al177/tranz330_re/tranz330_re.pdf

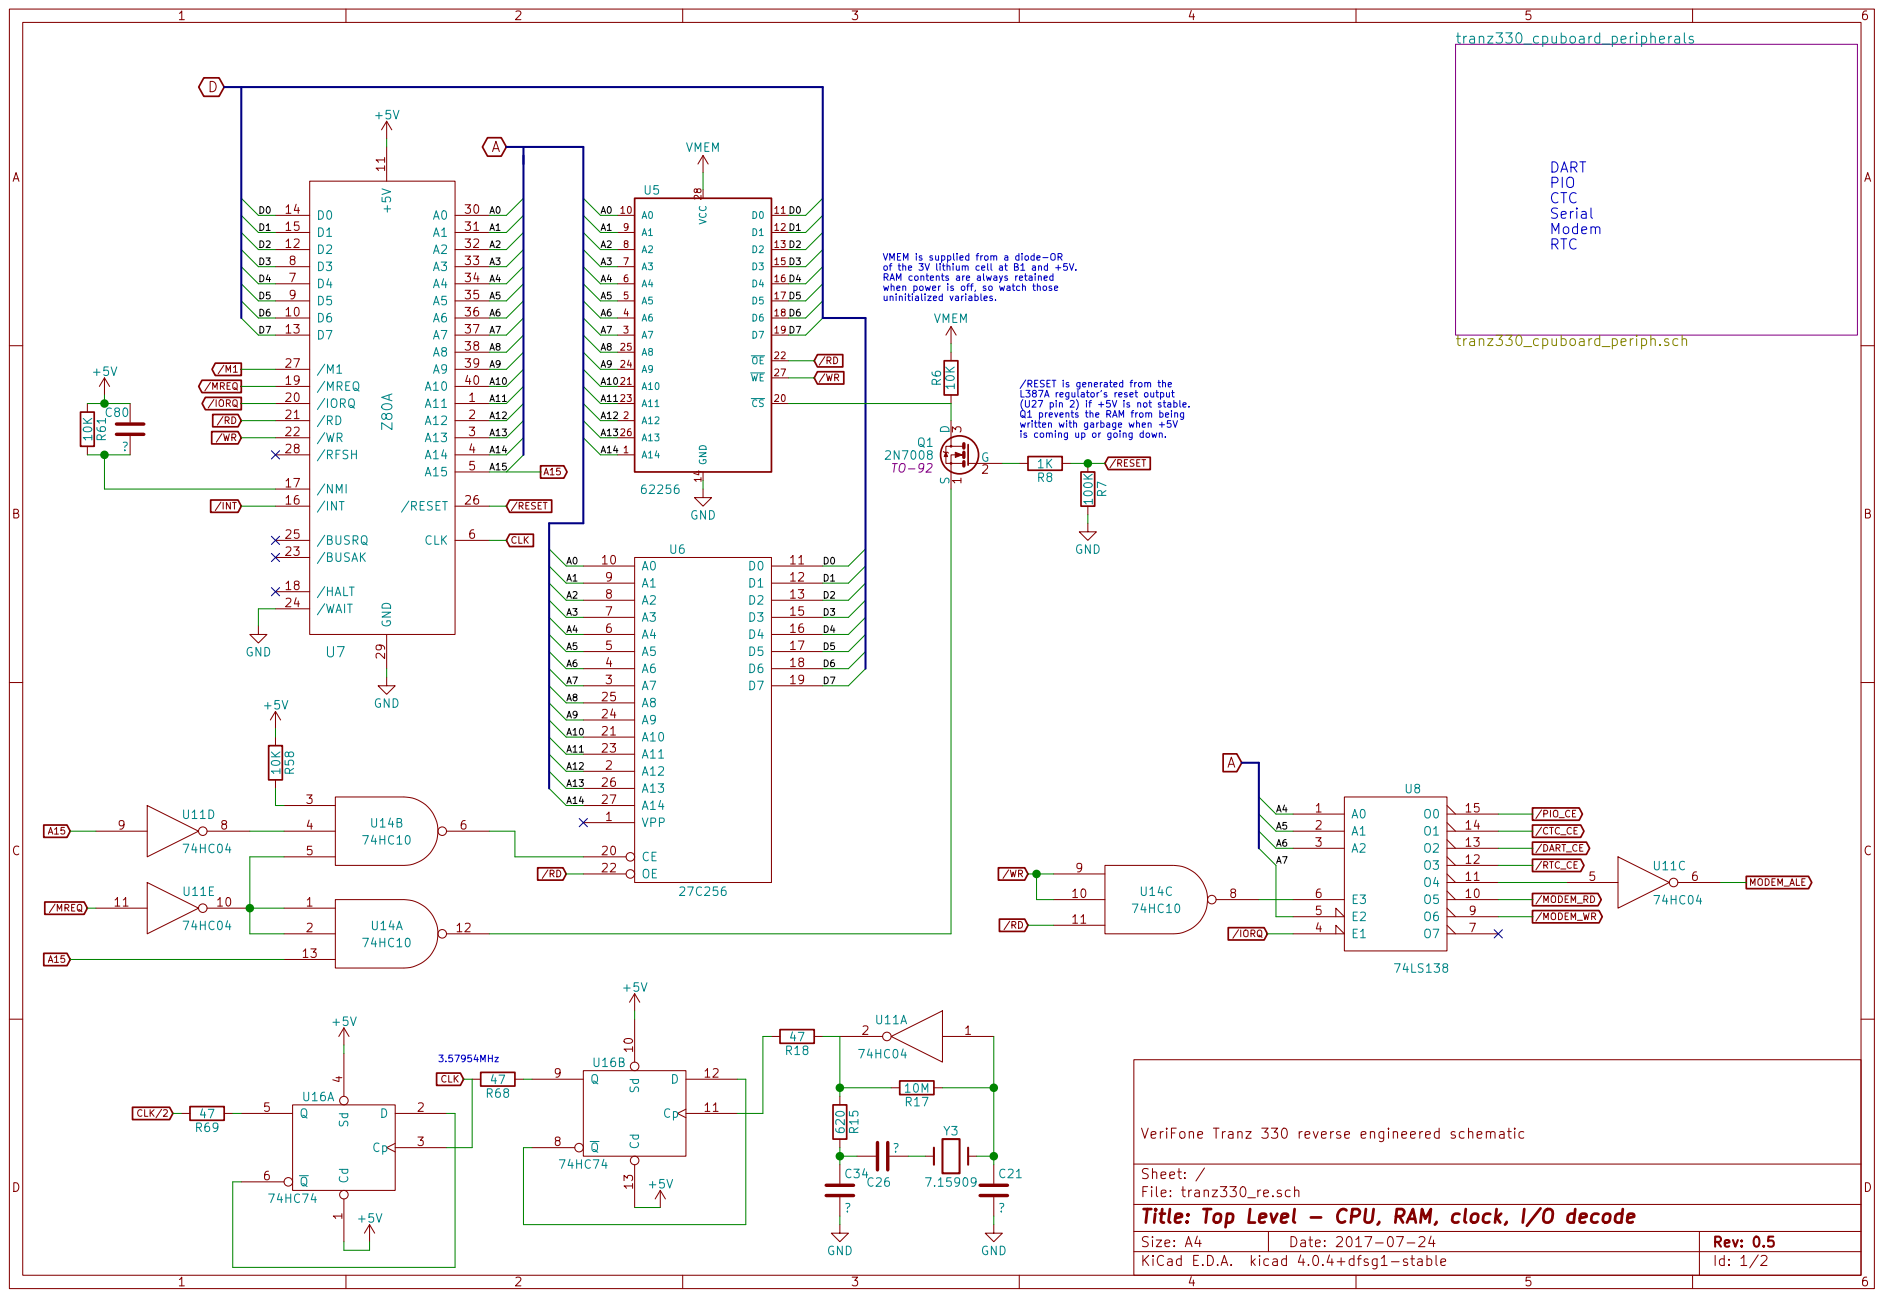
[picture p1: page 1]

is coming up or going down. VMEM is supplied from a diode-OR
of the 3V lithium cell at B1 and +5V. RAM contents are always retained when power is off, so watch those

/RESET is generated from the
L387A regulator's reset output (U27 pin 2) if +5V is not stable. Q1 prevents the RAM from being written with garbage when +5V

File: tranz330_re.sch Sheet: / VeriFone Tranz 330 reverse engineered schematic

Id: 1/2 Title: Top Level - CPU, RAM, clock, I/O decode

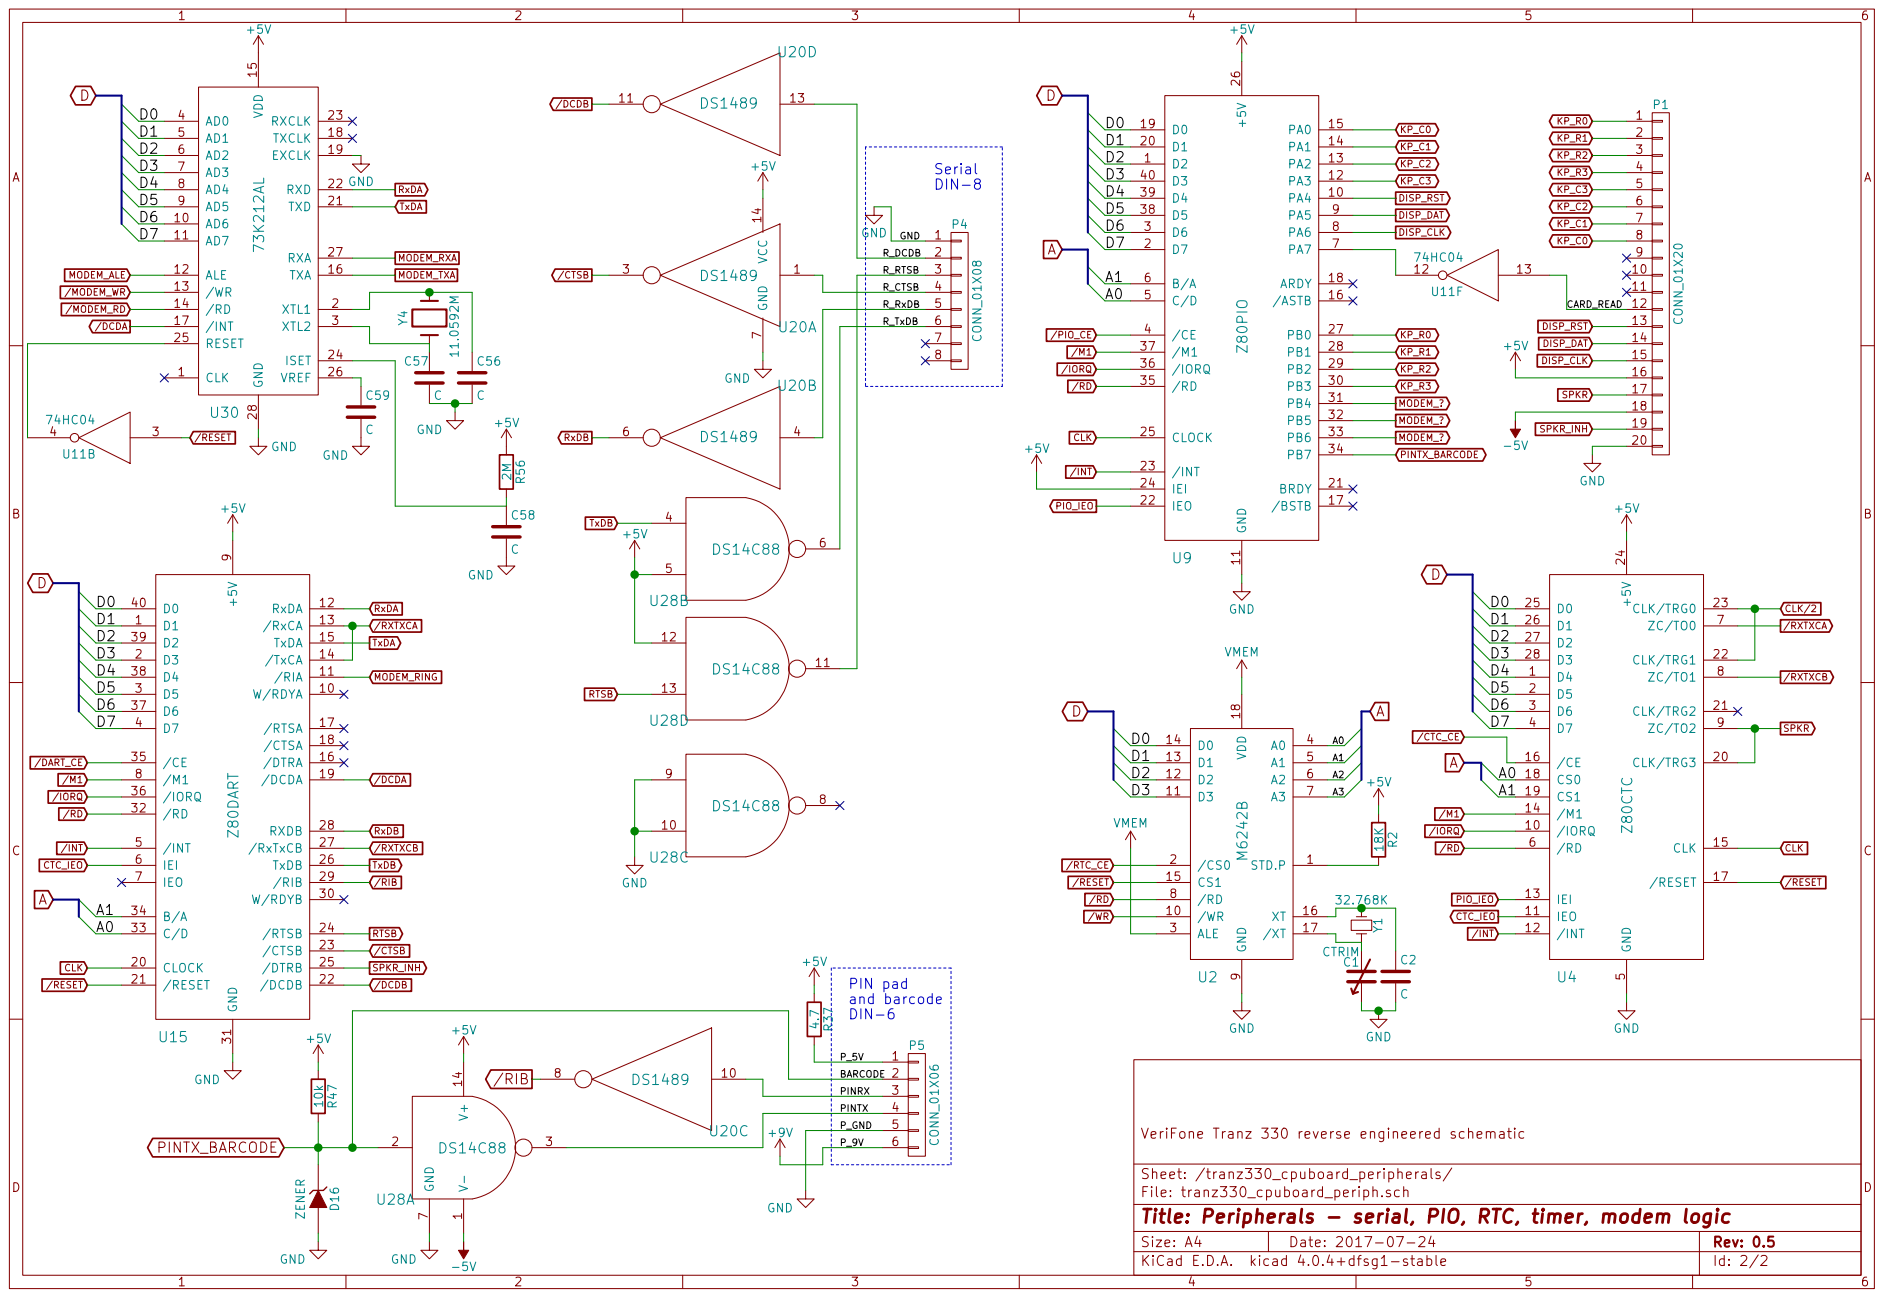
[picture p2: page 2]

and barcode DIN-6

3 PINRX

5 P_GND
P_9V

Sheet: /tranz330_cpuboard_peripherals/
File: tranz330_cpuboard_periph.sch
Id: 2/2 Title: Peripherals - serial, PIO, RTC, timer, modem logic
