al177/tranz330_re/tranz330_cpuboard_periph.sch

## KiCad design tranz330_cpuboard_periph.sch (2017-07-25)

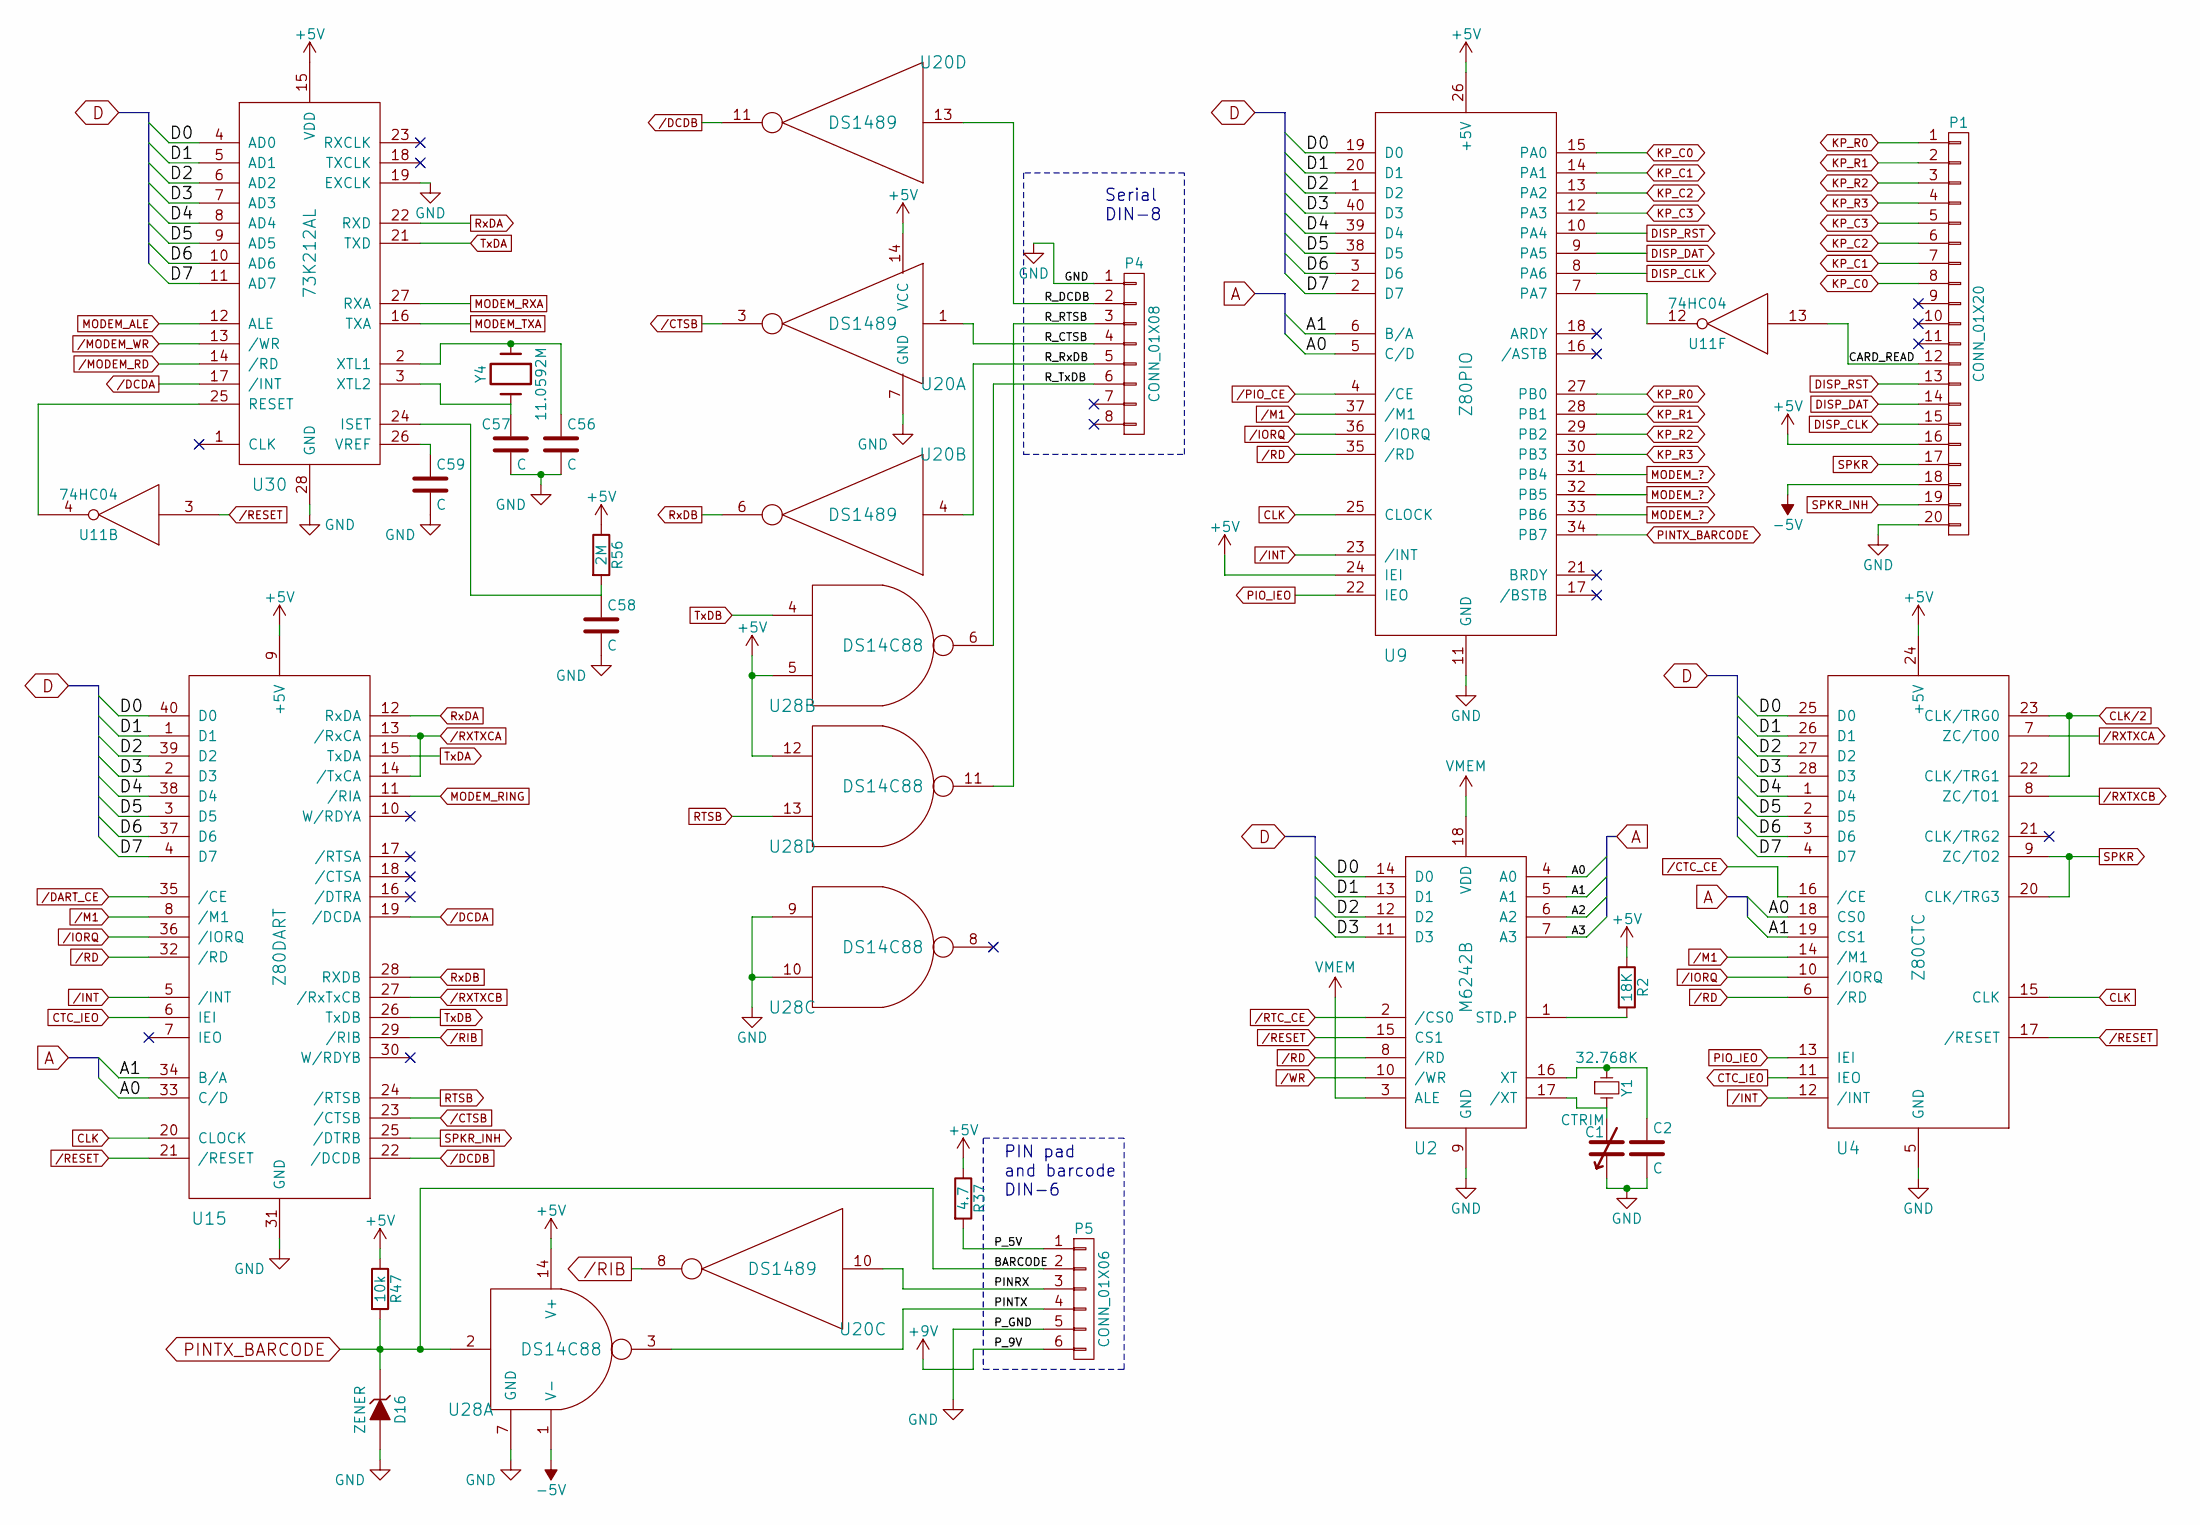
[picture p3: schematic tranz330_cpuboard_periph.sch]

Parts:
C1: CTRIM
C2, C56, C57, C58, C59: C
D16: ZENER
P1: CONN_01X20
P4: CONN_01X08
P5: CONN_01X06
R2: 18K
R37: 4.7
R47: 10k
R56: 2M
U2: M6242B
U4: Z80CTC
U9: Z80PIO
U11: 74HC04
U15: Z80DART
U20: DS1489
U28: DS14C88
U30: 73K212AL
Y1: 32.768K
Y4: 11.0592M

Connections:
+5V: P1.16, R2.1, R37.1, R47.1, R56.1, U4.24 (+5V), U9.24 (IEI), U9.26 (+5V), U15.9 (+5V), U20.14 (VCC), U28.5, U28.12, U28.14 (V+), U30.15 (VDD)
+9V: P5.6
-5V: P1.18, U28.1 (V-)
/CTC_CE: U4.16 (/CE)
/CTSB: U15.23 (/CTSB), U20.3
/DART_CE: U15.35 (/CE)
/DCDA: U15.19 (/DCDA), U30.17 (/INT)
/DCDB: U15.22 (/DCDB), U20.11
/INT: U4.12 (/INT), U9.23 (/INT), U15.5 (/INT)
/IORQ: U4.10 (/IORQ), U9.36 (/IORQ), U15.36 (/IORQ)
/M1: U4.14 (/M1), U9.37 (/M1), U15.8 (/M1)
/MODEM_RD: U30.14 (/RD)
/MODEM_WR: U30.13 (/WR)
/PIO_CE: U9.4 (/CE)
/RD: U2.8 (/RD), U4.6 (/RD), U9.35 (/RD), U15.32 (/RD)
/RESET: U2.15 (CS1), U4.17 (/RESET), U11.3, U15.21 (/RESET)
/RIB: U15.29 (/RIB), U20.8
/RTC_CE: U2.2 (/CS0)
/RXTXCA: U4.7 (ZC/TO0), U15.13 (/RxCA), U15.14 (/TxCA)
/RXTXCB: U4.8 (ZC/TO1), U15.27 (/RxTxCB)
/WR: U2.10 (/WR)
A0: U2.4 (A0), U4.18 (CS0), U9.5 (C/D), U15.33 (C/D)
A1: U2.5 (A1), U4.19 (CS1), U9.6 (B/A), U15.34 (B/A)
A2: U2.6 (A2)
A3: U2.7 (A3)
CARD_READ: P1.12, U11.13
CLK: U4.15 (CLK), U9.25 (CLOCK), U15.20 (CLOCK)
CLK/2: U4.22 (CLK/TRG1), U4.23 (CLK/TRG0)
CTC_IEO: U4.11 (IEO), U15.6 (IEI)
D0: U2.14 (D0), U4.25 (D0), U9.19 (D0), U15.40 (D0), U30.4 (AD0)
D1: U2.13 (D1), U4.26 (D1), U9.20 (D1), U15.1 (D1), U30.5 (AD1)
D2: U2.12 (D2), U4.27 (D2), U9.1 (D2), U15.39 (D2), U30.6 (AD2)
D3: U2.11 (D3), U4.28 (D3), U9.40 (D3), U15.2 (D3), U30.7 (AD3)
D4: U4.1 (D4), U9.39 (D4), U15.38 (D4), U30.8 (AD4)
D5: U4.2 (D5), U9.38 (D5), U15.3 (D5), U30.9 (AD5)
D6: U4.3 (D6), U9.3 (D6), U15.37 (D6), U30.10 (AD6)
D7: U4.4 (D7), U9.2 (D7), U15.4 (D7), U30.11 (AD7)
DISP_CLK: P1.15, U9.8 (PA6)
DISP_DAT: P1.14, U9.9 (PA5)
DISP_RST: P1.13, U9.10 (PA4)
GND: C1.1, C2.2, C56.2, C57.2, C58.2, C59.2, D16.2 (A), P1.20, P4.1, P5.5, U2.9 (GND), U4.5 (GND), U9.11 (GND), U15.31 (GND), U20.7 (GND), U28.7 (GND), U28.9, U28.10, U30.19 (EXCLK), U30.28 (GND)
KP_C0: P1.8, U9.15 (PA0)
KP_C1: P1.7, U9.14 (PA1)
KP_C2: P1.6, U9.13 (PA2)
KP_C3: P1.5, U9.12 (PA3)
KP_R0: P1.1, U9.27 (PB0)
KP_R1: P1.2, U9.28 (PB1)
KP_R2: P1.3, U9.29 (PB2)
KP_R3: P1.4, U9.30 (PB3)
MODEM_?: U9.31 (PB4), U9.32 (PB5), U9.33 (PB6)
MODEM_ALE: U30.12 (ALE)
MODEM_RING: U15.11 (/RIA)
MODEM_RXA: U30.27 (RXA)
MODEM_TXA: U30.16 (TXA)
unnamed: C1.2, U2.17 (/XT), Y1.2
unnamed: C2.1, U2.16 (XT), Y1.1
unnamed: C56.1, U30.2 (XTL1), Y4.1
unnamed: C57.1, U30.3 (XTL2), Y4.2
unnamed: C58.1, R56.2, U30.24 (ISET)
unnamed: C59.1, U30.26 (VREF)
unnamed: R2.2, U2.1 (STD.P)
unnamed: U11.4, U30.25 (RESET)
unnamed: U9.7 (PA7), U11.12
PINRX: P5.3, U20.10
PINTX: P5.4, U28.3
PINTX_BARCODE: D16.1 (K), P5.2, R47.2, U9.34 (PB7), U28.2
PIO_IEO: U4.13 (IEI), U9.22 (IEO)
P_5V: P5.1, R37.2
RTSB: U15.24 (/RTSB), U28.13
R_CTSB: P4.4, U20.1
R_DCDB: P4.2, U20.13
R_RTSB: P4.3, U28.11
R_RxDB: P4.5, U20.4
R_TxDB: P4.6, U28.6
RxDA: U15.12 (RxDA), U30.22 (RXD)
RxDB: U15.28 (RXDB), U20.6
SPKR: P1.17, U4.9 (ZC/TO2), U4.20 (CLK/TRG3)
SPKR_INH: P1.19, U15.25 (/DTRB)
TxDA: U15.15 (TxDA), U30.21 (TXD)
TxDB: U15.26 (TxDB), U28.4
VMEM: U2.3 (ALE), U2.18 (VDD)

Notes on the sheet:
Serial DIN-8
PIN pad and barcode DIN-6
