al177/tranz330_re/tranz330_re.sch

## KiCad design tranz330_re.sch (2017-07-25)

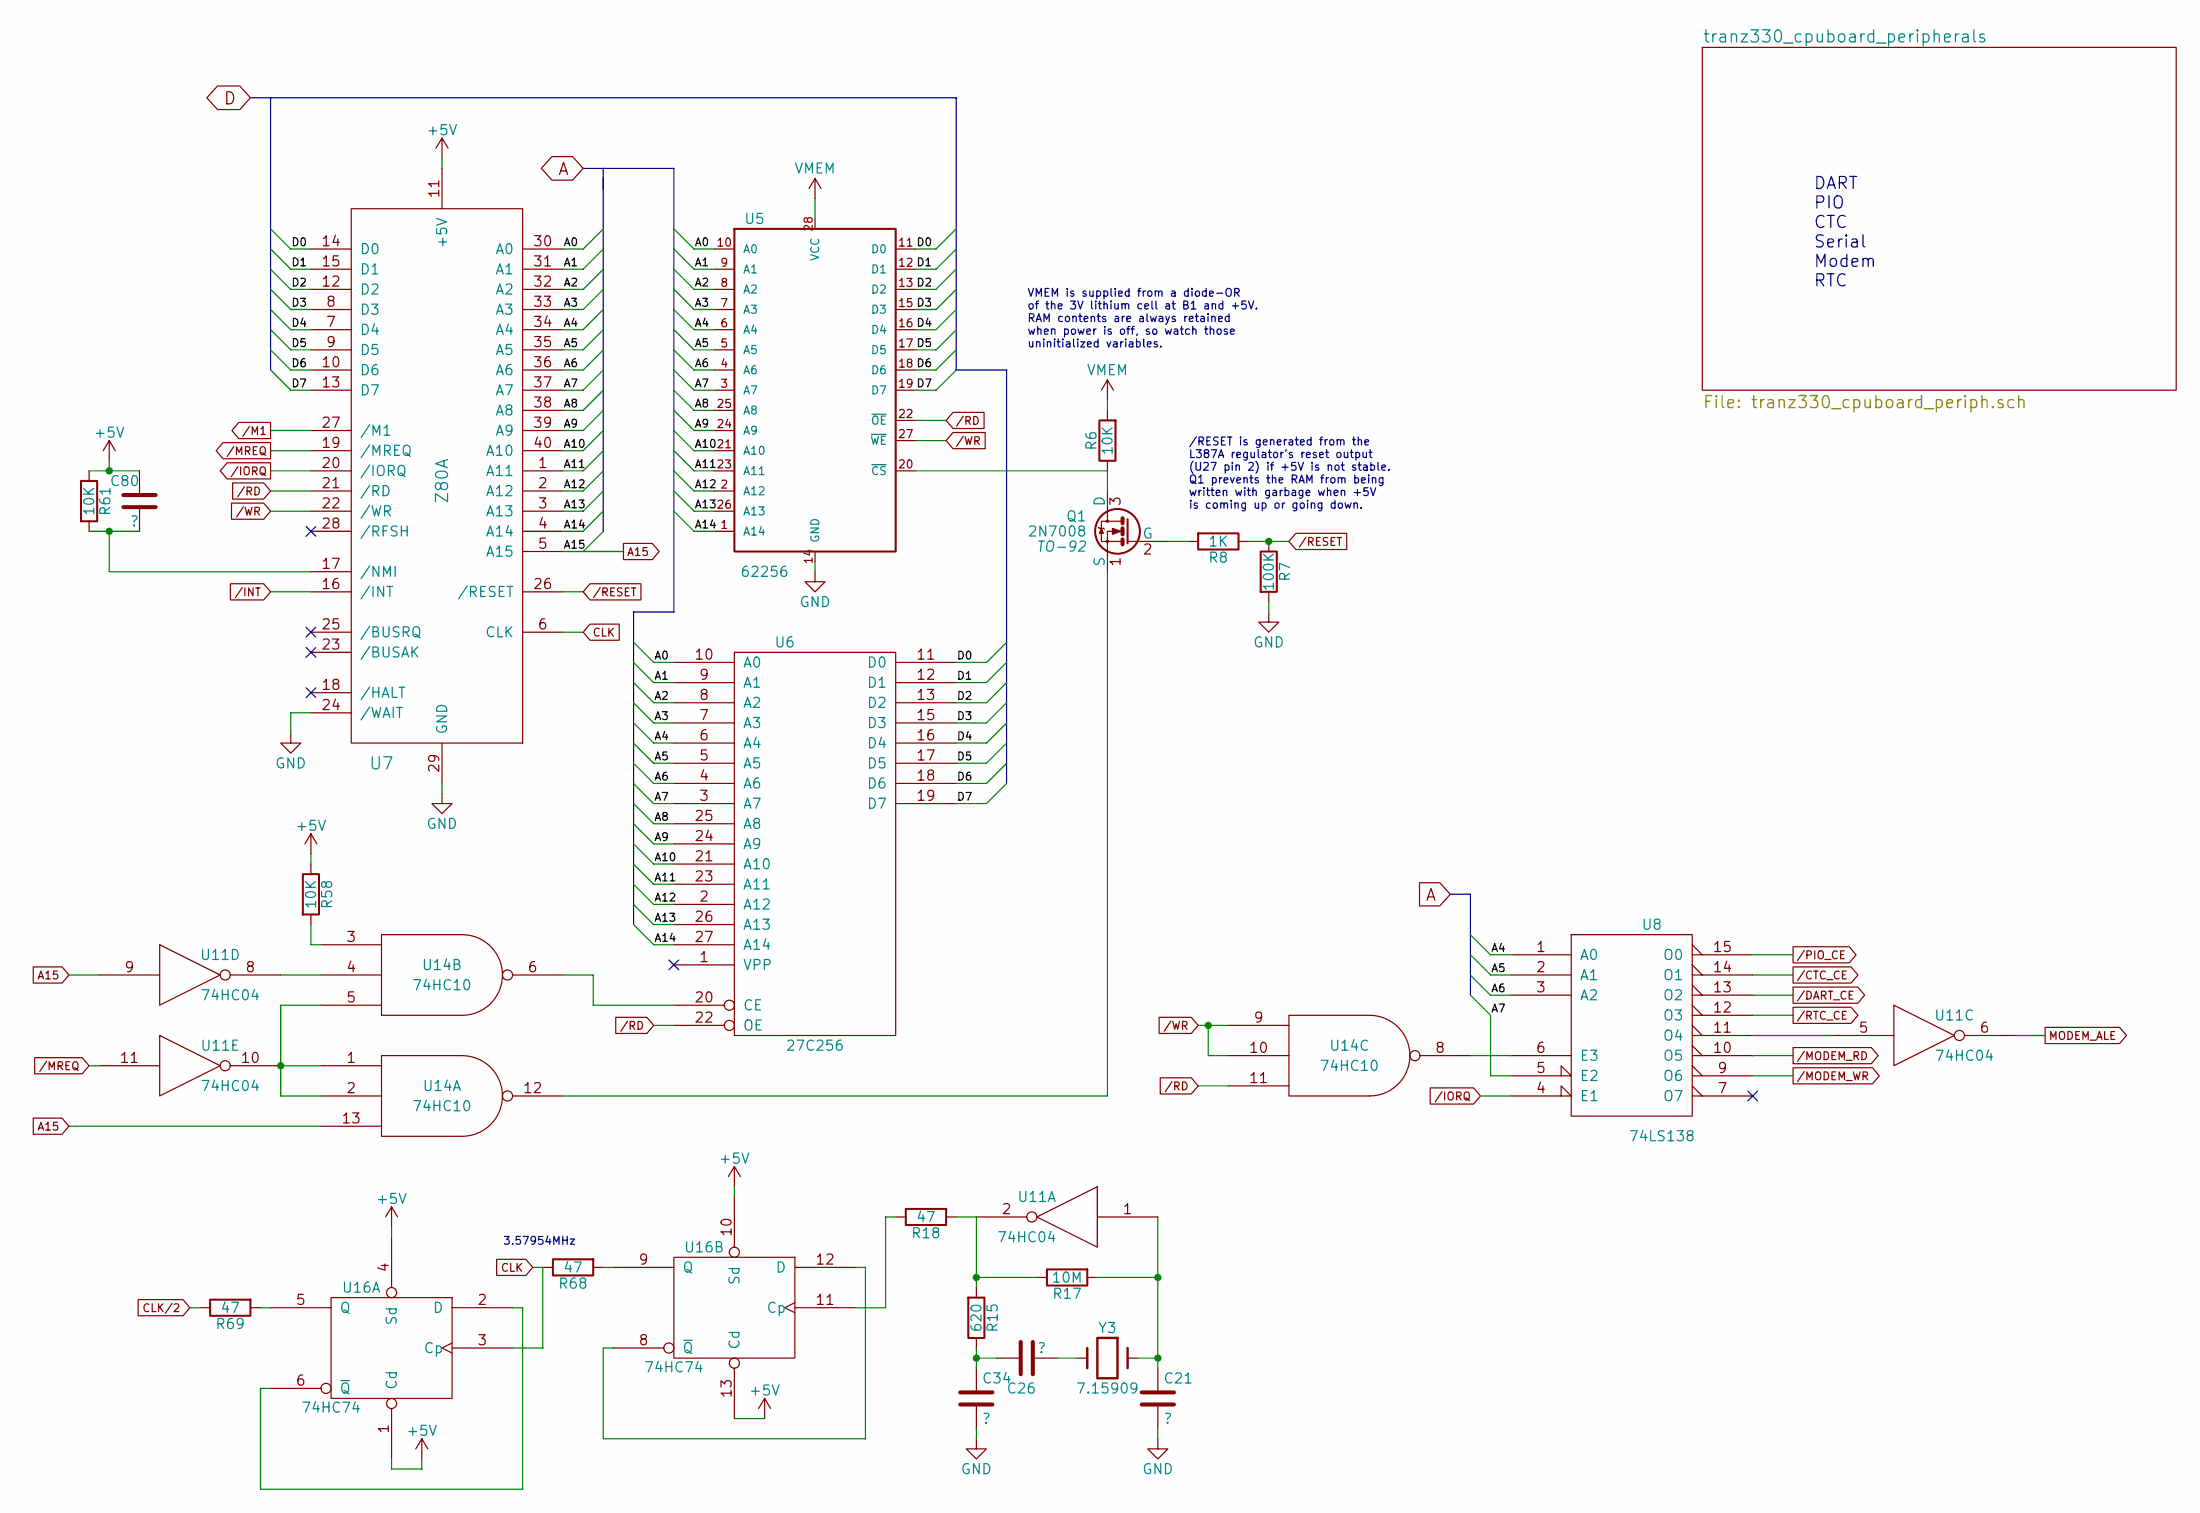
[picture p4: schematic tranz330_re.sch]

Parts:
C21, C26, C34, C80: ?
Q1: 2N7008; TO-92
R6, R58, R61: 10K
R7: 100K
R8: 1K
R15: 620
R17: 10M
R18, R68, R69: 47
U5: 62256; DIP28
U6: 27C256
U7: Z80A
U8: 74LS138
U11: 74HC04
U14: 74HC10
U16: 74HC74
Y3: 7.15909

Connections:
+5V: C80.1, R58.1, R61.1, U7.11 (+5V), U16.1 (Cd), U16.4 (Sd), U16.10 (Sd), U16.13 (Cd)
/CTC_CE: U8.14 (O1)
/DART_CE: U8.13 (O2)
/INT: U7.16 (/INT)
/IORQ: U7.20 (/IORQ), U8.4 (E1)
/M1: U7.27 (/M1)
/MODEM_RD: U8.10 (O5)
/MODEM_WR: U8.9 (O6)
/MREQ: U7.19 (/MREQ), U11.11
/PIO_CE: U8.15 (O0)
/RD: U5.22 (~OE), U6.22 (OE), U7.21 (/RD), U14.11
/RESET: R7.1, R8.1, U7.26 (/RESET)
/RTC_CE: U8.12 (O3)
/WR: U5.27 (~WE), U7.22 (/WR), U14.9, U14.10
A0: U5.10 (A0), U6.10 (A0), U7.30 (A0)
A1: U5.9 (A1), U6.9 (A1), U7.31 (A1)
A2: U5.8 (A2), U6.8 (A2), U7.32 (A2)
A3: U5.7 (A3), U6.7 (A3), U7.33 (A3)
A4: U5.6 (A4), U6.6 (A4), U7.34 (A4), U8.1 (A0)
A5: U5.5 (A5), U6.5 (A5), U7.35 (A5), U8.2 (A1)
A6: U5.4 (A6), U6.4 (A6), U7.36 (A6), U8.3 (A2)
A7: U5.3 (A7), U6.3 (A7), U7.37 (A7), U8.5 (E2)
A8: U5.25 (A8), U6.25 (A8), U7.38 (A8)
A9: U5.24 (A9), U6.24 (A9), U7.39 (A9)
A10: U5.21 (A10), U6.21 (A10), U7.40 (A10)
A11: U5.23 (A11), U6.23 (A11), U7.1 (A11)
A12: U5.2 (A12), U6.2 (A12), U7.2 (A12)
A13: U5.26 (A13), U6.26 (A13), U7.3 (A13)
A14: U5.1 (A14), U6.27 (A14), U7.4 (A14)
A15: U7.5 (A15), U11.9, U14.13
CLK: R68.1, U7.6 (CLK), U16.3 (Cp)
CLK/2: R69.1
D0: U5.11 (D0), U6.11 (D0), U7.14 (D0)
D1: U5.12 (D1), U6.12 (D1), U7.15 (D1)
D2: U5.13 (D2), U6.13 (D2), U7.12 (D2)
D3: U5.15 (D3), U6.15 (D3), U7.8 (D3)
D4: U5.16 (D4), U6.16 (D4), U7.7 (D4)
D5: U5.17 (D5), U6.17 (D5), U7.9 (D5)
D6: U5.18 (D6), U6.18 (D6), U7.10 (D6)
D7: U5.19 (D7), U6.19 (D7), U7.13 (D7)
GND: C21.2, C34.2, R7.2, U5.14 (GND), U7.24 (/WAIT), U7.29 (GND)
MODEM_ALE: U11.6
unnamed: C21.1, R17.2, U11.1, Y3.1
unnamed: C26.1, C34.1, R15.1
unnamed: C26.2, Y3.2
unnamed: C80.2, R61.2, U7.17 (/NMI)
unnamed: Q1.1 (S), U14.12
unnamed: Q1.2 (G), R8.2
unnamed: Q1.3 (D), R6.1, U5.20 (~CS)
unnamed: R15.2, R17.1, R18.2, U11.2
unnamed: R18.1, U16.11 (Cp)
unnamed: R58.2, U14.3
unnamed: R68.2, U16.9 (Q)
unnamed: R69.2, U16.5 (Q)
unnamed: U8.11 (O4), U11.5
unnamed: U11.8, U14.4
unnamed: U11.10, U14.1, U14.2, U14.5
unnamed: U6.20 (CE), U14.6
unnamed: U8.6 (E3), U14.8
unnamed: U16.2 (D), U16.6 (~Q)
unnamed: U16.8 (~Q), U16.12 (D)
VMEM: R6.2, U5.28 (VCC)

Notes on the sheet:
3.57954MHz
DART PIO CTC Serial Modem RTC
/RESET is generated from the L387A regulator's reset output (U27 pin 2) if +5V is not stable. Q1 prevents the RAM from being written with garbage when +5V is coming up or going down.
VMEM is supplied from a diode-OR of the 3V lithium cell at B1 and +5V. RAM contents are always retained when power is off, so watch those uninitialized variables.
