al177/tranz330_re/(commit log)

2017-07-17 Add interrupt enable chain, note on reset, PDF version
    [tranz330_cpuboard_periph.sch, tranz330_re.sch]
2017-07-17 Fix the modem xtal frequency
    [tranz330_cpuboard_periph.sch]
2017-07-21 Fixed broken C/D & B/A addressing on DART and PIO
    [tranz330_cpuboard_periph.sch]
2017-07-25 Fix /RTSB, better PDF output, trace missing DART and modem pins
    [tranz330_cpuboard_periph.sch, tranz330_re.sch]
